bpijls/ei-beacon/docs/ei-beacons.jpg

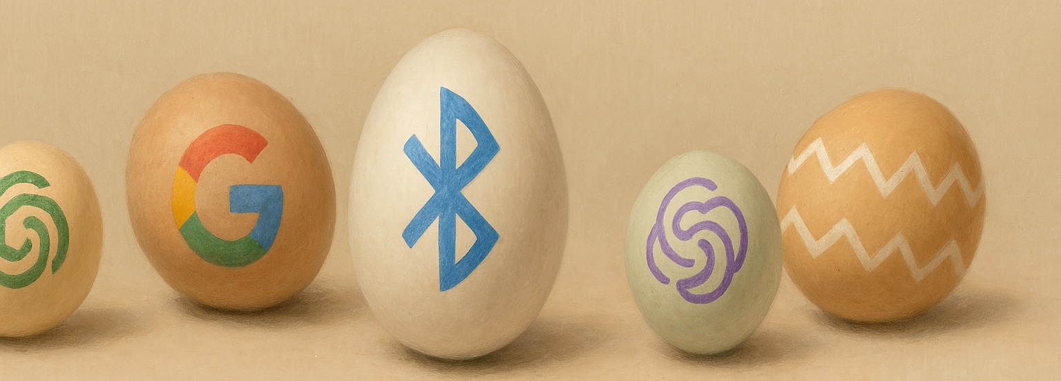
docs/ei-beacons.jpg
