bpijls/ei-beacon/enclosure/eiBeaconBottom.stl

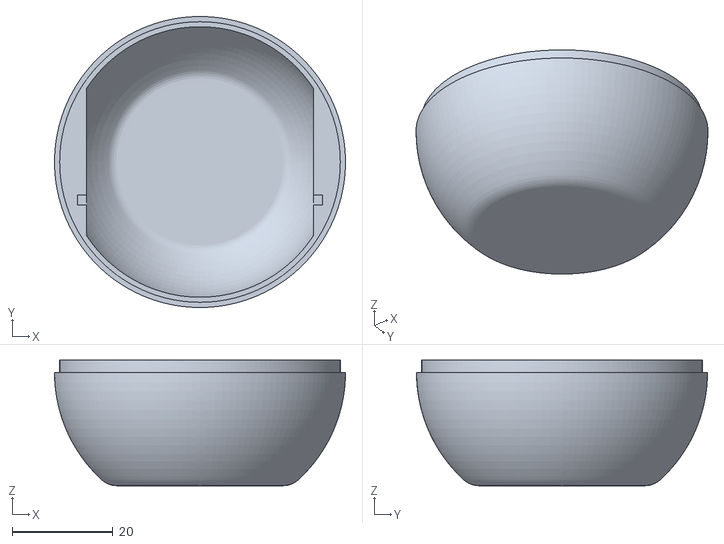
[picture p7: CAD file, 2025-04-14]
enclosure/eiBeaconBottom.stl
57.8 x 57.8 x 24.9
