bpijls/ei-beacon/pcb/board_outline.dxf

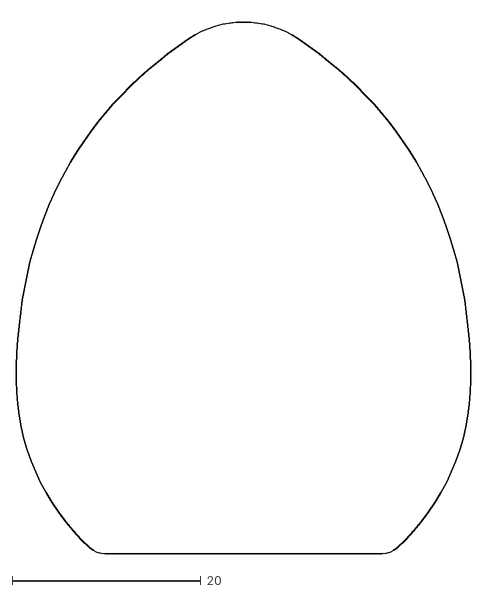
[picture p8: CAD file, 2025-04-14]
pcb/board_outline.dxf
48.1 x 56.9
