bpijls/ei-beacon/enclosure/eiBeacon_top.stl

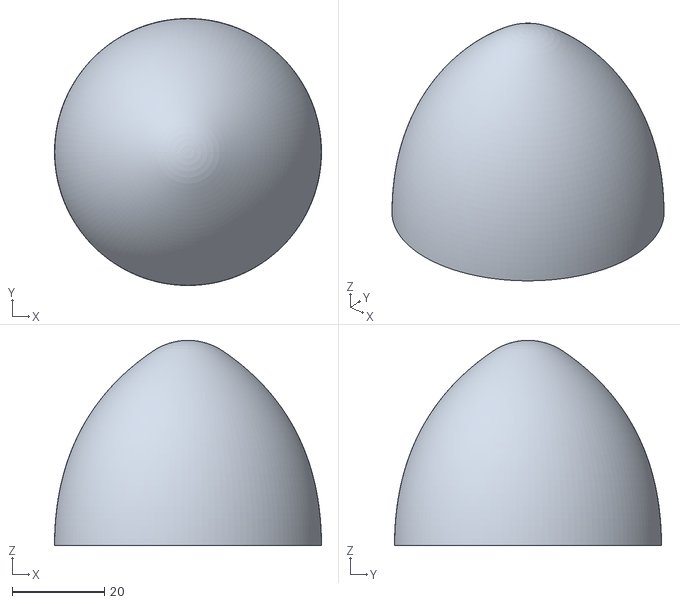
[picture p9: CAD file, 2025-04-14]
enclosure/eiBeacon_top.stl
57.8 x 57.8 x 44.4
