bpijls/ei-beacon/(list of files, cad)

Other CAD files:
enclosure/eiBeaconmm.3dm
enclosure/eiBeaconmm_shell.3dm
