bpijls/ei-beacon/(commit log)

2025-04-14 Update eibeacon documentation to include GPIO pin assignments and firmware link
2025-04-14 Update enclosure printing instructions for clarity
2025-04-14 Add PCB description to index.md for clarity
2025-04-14 Fix beacon configuration by updating major and minor values in initBeacon function
    [ei-beacon.ino]
